TinyTapeout/ttsky25a-tinyQVb/fpga/generic/top.v

/*
 * Copyright (c) 2024-2025 Michael Bell
 * SPDX-License-Identifier: Apache-2.0
 */

`default_nettype none

module tinyQV_top (
        input clk,
        input rst_n,

        input [7:0] ui_in,
        output [7:0] uo_out

);
    localparam CLOCK_MHZ = 14;

    // Address to peripheral map
    localparam PERI_NONE = 4'h0;
    localparam PERI_GPIO_OUT_SEL = 4'h3;
    localparam PERI_DEBUG_UART = 4'h6;
    localparam PERI_DEBUG_UART_STATUS = 4'h7;
    localparam PERI_DEBUG = 4'hC;
    localparam PERI_USER = 4'hF;

    // Register the reset on the negative edge of clock for safety.
    // This also allows the option of async reset in the design, which might be preferable in some cases
    /* verilator lint_off SYNCASYNCNET */
    reg rst_reg_n;
    /* verilator lint_on SYNCASYNCNET */
    always @(negedge clk) rst_reg_n <= rst_n;

    // Bidirs are used for SPI interface
    wire [3:0] qspi_data_in;
    wire [3:0] qspi_data_out;
    wire [3:0] qspi_data_oe;
    wire       qspi_clk_out;
    wire       qspi_flash_select;
    wire       qspi_ram_a_select;
    wire       qspi_ram_b_select;

    sim_qspi_pmod i_qspi (
        .qspi_data_in(qspi_data_out & qspi_data_oe),
        .qspi_data_out(qspi_data_in),
        .qspi_clk(qspi_clk_out),

        .qspi_flash_select(qspi_flash_select),
        .qspi_ram_a_select(qspi_ram_a_select),
        .qspi_ram_b_select(qspi_ram_b_select)
    );

    wire [27:0] addr;
    wire  [1:0] write_n;
    wire  [1:0] read_n;
    wire        read_complete;
    wire [31:0] data_to_write;

    wire        data_ready;
    reg [31:0] data_from_read;

    wire       debug_instr_complete;
    wire       debug_instr_ready;
    wire       debug_instr_valid;
    wire       debug_fetch_restart;
    wire       debug_data_ready;
    wire       debug_interrupt_pending;
    wire       debug_branch;
    wire       debug_early_branch;
    wire       debug_ret;
    wire       debug_reg_wen;
    wire       debug_counter_0;
    wire       debug_data_continue;
    wire       debug_stall_txn;
    wire       debug_stop_txn;
    wire [3:0] debug_rd;

    wire       debug_uart_txd;
    wire       debug_signal;
    reg  [7:6] gpio_out_sel;

    reg [3:0] connect_peripheral;

    // Debug
    reg debug_register_data;
    reg [3:0] debug_rd_r;

    // Debug UART - runs fast to reduce the width of the count necessary for the divider!
    wire debug_uart_tx_busy;
    wire debug_uart_tx_start = write_n != 2'b11 && connect_peripheral == PERI_DEBUG_UART;

    // Time
    wire time_pulse;

    // Peripherals interface
    wire [7:0] peri_out;
    wire [31:0] peri_data_out;
    wire        peri_data_ready;
    wire [15:2] peri_interrupts;

    // Peripherals get synchronized ui_in.
    reg [7:0] ui_in_sync0;
    reg [7:0] ui_in_sync;
    always @(posedge clk) begin
        ui_in_sync0 <= ui_in;
        ui_in_sync <= ui_in_sync0;
    end

    // Interrupt requests
    wire [15:0] interrupt_req = {peri_interrupts, ui_in_sync[1:0]};

    tinyQV i_tinyqv(
        .clk(clk),
        .rstn(rst_reg_n),

        .data_addr(addr),
        .data_write_n(write_n),
        .data_read_n(read_n),
        .data_read_complete(read_complete),
        .data_out(data_to_write),

        .data_ready(data_ready),
        .data_in(data_from_read),

        .interrupt_req(interrupt_req),
        .time_pulse(time_pulse),

        .spi_data_in(rst_reg_n ? qspi_data_in : 4'b0010),
        .spi_data_out(qspi_data_out),
        .spi_data_oe(qspi_data_oe),
        .spi_clk_out(qspi_clk_out),
        .spi_flash_select(qspi_flash_select),
        .spi_ram_a_select(qspi_ram_a_select),
        .spi_ram_b_select(qspi_ram_b_select),

        .debug_instr_complete(debug_instr_complete),
        .debug_instr_ready(debug_instr_ready),
        .debug_instr_valid(debug_instr_valid),
        .debug_fetch_restart(debug_fetch_restart),
        .debug_data_ready(debug_data_ready),
        .debug_interrupt_pending(debug_interrupt_pending),
        .debug_branch(debug_branch),
        .debug_early_branch(debug_early_branch),
        .debug_ret(debug_ret),
        .debug_reg_wen(debug_reg_wen),
        .debug_counter_0(debug_counter_0),
        .debug_data_continue(debug_data_continue),
        .debug_stall_txn(debug_stall_txn),
        .debug_stop_txn(debug_stop_txn),
        .debug_rd(debug_rd)
    );

    assign uo_out[0] = peri_out[0];
    assign uo_out[1] = peri_out[1];
    assign uo_out[2] = debug_register_data ? debug_rd_r[0] : peri_out[2];
    assign uo_out[3] = debug_register_data ? debug_rd_r[1] : peri_out[3];
    assign uo_out[4] = debug_register_data ? debug_rd_r[2] : peri_out[4];
    assign uo_out[5] = debug_register_data ? debug_rd_r[3] : peri_out[5];
    assign uo_out[6] = gpio_out_sel[6] ? peri_out[6] : debug_uart_txd;
    assign uo_out[7] = gpio_out_sel[7] ? peri_out[7] : debug_signal;

    tinyQV_peripherals #(.CLOCK_MHZ(CLOCK_MHZ)) i_peripherals (
        .clk(clk),
        .rst_n(rst_reg_n),

        .ui_in(ui_in_sync),
        .uo_out(peri_out),

        .addr_in(addr[10:0]),
        .data_in(data_to_write),

        .data_write_n(write_n),
        .data_read_n(read_n),

        .data_out(peri_data_out),
        .data_ready(peri_data_ready),

        .data_read_complete(read_complete),

        .user_interrupts(peri_interrupts)
    );

    always @(*) begin
        if ({addr[27:6], addr[1:0]} == 24'h800000) 
            connect_peripheral = addr[5:2];
        else if (addr[27:11] == 17'h10000)
            connect_peripheral = PERI_USER;
        else
            connect_peripheral = PERI_NONE;
    end

    // Read data
    always @(*) begin
        case (connect_peripheral)
            PERI_GPIO_OUT_SEL:data_from_read = {24'h0, gpio_out_sel, 6'h0};
            PERI_DEBUG_UART_STATUS: data_from_read = {31'h0, debug_uart_tx_busy};
            PERI_USER:        data_from_read = peri_data_out;
            default:          data_from_read = 32'hFFFF_FFFF;
        endcase
    end

    assign data_ready = (connect_peripheral == PERI_USER) ? peri_data_ready : 1'b1;

    // GPIO Out
    always @(posedge clk) begin
        if (!rst_reg_n) begin
            gpio_out_sel <= {!ui_in[0], 1'b0};
        end
        if (write_n != 2'b11) begin
            if (connect_peripheral == PERI_GPIO_OUT_SEL) gpio_out_sel <= data_to_write[7:6];
        end
    end

    uart_tx #(.CLK_HZ(CLOCK_MHZ*1_000_000), .BIT_RATE(1_000_000)) i_debug_uart_tx(
        .clk(clk),
        .resetn(rst_reg_n),
        .uart_txd(debug_uart_txd),
        .uart_tx_en(debug_uart_tx_start),
        .uart_tx_data(data_to_write[7:0]),
        .uart_tx_busy(debug_uart_tx_busy) 
    );

    reg [7:0] time_count;
    always @(posedge clk) begin
        if (!rst_reg_n) begin
            time_count <= 0;
        end else begin
            if (time_count == (CLOCK_MHZ - 1)) time_count <= 0;
            else time_count <= time_count + 1;
        end
    end
    assign time_pulse = time_count == (CLOCK_MHZ - 1);

    // Debug
    always @(posedge clk) begin
        if (!rst_reg_n)
            debug_register_data <= ui_in[1];
        else if (write_n != 2'b11 && connect_peripheral == PERI_DEBUG)
            debug_register_data <= data_to_write[0];
    end

    always @(posedge clk) begin
        debug_rd_r <= debug_rd;
    end

/*
    reg [15:0] debug_signals;
    always @(*) begin
        debug_signals  = {debug_instr_complete,
                          debug_instr_ready,
                          debug_instr_valid,
                          debug_fetch_restart,
                          read_n != 2'b11,
                          write_n != 2'b11,
                          debug_data_ready,
                          debug_interrupt_pending,
                          debug_branch,
                          debug_early_branch,
                          debug_ret,
                          debug_reg_wen,
                          debug_counter_0,
                          debug_data_continue,
                          debug_stall_txn,
                          debug_stop_txn};
    end
    assign debug_signal = debug_signals[ui_in[6:3]];
*/
    assign debug_signal = 1'b0;

endmodule
