TinyTapeout/ttsky25a-tinyQVb/src/user_peripherals/AY8913/noise.v

// FROM General Instruments AY-3-8910 / 8912 Programmable Sound Generator (PSG) data Manual.
// Section 3.2 Noise Generator Control
// ...
// Note that the 6-bit value in R11 is a period value-the higher the value in the register,
// the lower the resultant noise frequency. Note also that, as with the Tone Period,
// the lowest period value is 00001 (divide by 1); the highest period value is 11111 (divide by 3110).

// LFSR in hardware implementation uses 2 taps and adds extra 1 when LFSR is equal to 0.

// MAME does not check for LFSR==0 and uses single XOR with 2 taps.
// Instead MAME initialises LFSR with 1 upon reset. This is not a bug!
// The following Python code validates that if LFSR is initialised with 1
//  - LFSR will never reach 0 and
//  - the cycle is 131070 iterations before LFSR reaches 1 again
//
//  lfsr = 1
//  for x in range(65536*16): lfsr = lfsr >> 1 | (((lfsr&1) ^ ((lfsr>>3)&1))<<16); print (lfsr,x) if lfsr <= 1 else None
//
// The following Python code measures randomness of LFSR
//  - 0/1 are distributed equally
//  - flips occur 50% of time - the same as when using rand()%1. NOTE that this effectively halves the frequency.
//
//  flips = 0; ones = 0; lfsr = 1
//  for x in range(65536*16): last = lfsr&1; lfsr = lfsr >> 1 | (((lfsr&1) ^ ((lfsr>>3)&1))<<16); flips += (last != lfsr&1); ones += lfsr&1==1
//  print(flips/(65536*16), ones/(65536*16))

module noise #( parameter LFSR_BITS = 17, LFSR_TAP0 = 0, LFSR_TAP1 = 3, parameter PERIOD_BITS = 5 ) (
    input  wire clk,
    input  wire enable,
    input  wire reset,
    input  wire [PERIOD_BITS-1:0] period,

    output wire  out
);
    wire trigger;
    tone #(.PERIOD_BITS(PERIOD_BITS)) tone (
        .clk(clk),
        .enable(enable),
        .reset(reset),
        .period(period),
        .out(trigger));

    wire trigger_edge;
    signal_edge signal_edge(
        .clk(clk),
        .reset(reset),
        .signal(trigger),
        .on_posedge(trigger_edge)               // similar to noise_shift_clk_cond [see: lvd]
                                                // @TODO: look-ahead rising-edge detect the noise flip-flop [see: dnotq]
    );

    reg [LFSR_BITS-1:0] lfsr;
    wire is_lfsr_zero = (lfsr == 0);            // more readable, but equivalent to
                                                // hardware implementation ~(|lfsr) [see: lvd]
    wire lfsr_shift_in = (lfsr[LFSR_TAP0] ^ lfsr[LFSR_TAP1]) | is_lfsr_zero;

    always @(posedge clk) begin
        if (trigger_edge)
            lfsr <= {lfsr_shift_in, lfsr[LFSR_BITS-1:1]};
    end
    assign out = ~lfsr[0];
endmodule
