TinyTapeout/ttsky25a-tinyQVb/src/user_peripherals/vgascope/vga_timing.v

`default_nettype none

// courtesy of htfab, https://github.com/htfab/tinyqv-baby-vga
// (modified to save gates and remove interrupt code)

module vga_timing_cc (
    input wire clk,
    input wire rst_n,
    output reg [5:0] x_hi,
    output reg [4:0] x_lo,
    output reg [4:0] y_hi,
    output reg [5:0] y_lo,
    output reg hsync,
    output reg vsync,
    output wire blank
);

// 1024x768 60Hz CVT (63.5 MHz pixel clock, rounded to 64 MHz) - courtesy of RebelMike

`define H_ROLL   31
`define H_FPORCH (32 * 32)
`define H_SYNC   (33 * 32 + 16)
`define H_BPORCH (36 * 32 + 24)
`define H_NEXT   (41 * 32 + 15)

`define V_ROLL   47
`define V_FPORCH (16 * 64)
`define V_SYNC   (16 * 64 + 3)
`define V_BPORCH (16 * 64 + 7)
`define V_NEXT   (16 * 64 + 35)

always @(posedge clk) begin
    if (!rst_n) begin
        x_hi <= 0;
        x_lo <= 0;
        y_hi <= 0;
        y_lo <= 0;
        hsync <= 0;
        vsync <= 0;
    end else begin
        if ({x_hi, x_lo} == `H_NEXT) begin
            x_hi <= 0;
            x_lo <= 0;
        end else if (x_lo == `H_ROLL) begin
            x_hi <= x_hi + 1;
            x_lo <= 0;
        end else begin
            x_lo <= x_lo + 1;
        end
        if ({x_hi, x_lo} == `H_SYNC) begin
            if({y_hi, y_lo} == `V_NEXT) begin
                y_hi <= 0;
                y_lo <= 0;
            end else if (y_lo == `V_ROLL) begin
                y_hi <= y_hi + 1;
                y_lo <= 0;
            end else begin
                y_lo <= y_lo + 1;
            end
        end
        hsync <= !({x_hi, x_lo} >= `H_SYNC && {x_hi, x_lo} < `H_BPORCH);
        vsync <= ({y_hi, y_lo} >= `V_SYNC && {y_hi, y_lo} < `V_BPORCH);
    end
end

//assign blank = ({x_hi, x_lo} >= `H_FPORCH || {y_hi, y_lo} >= `V_FPORCH);
assign blank = x_hi[5] | y_hi[4];

endmodule
