TinyTapeout/ttsky25a-tinyQVb/test/test.py

# SPDX-FileCopyrightText: © 2024 Michael Bell
# SPDX-License-Identifier: MIT

import random

import cocotb
from cocotb.clock import Clock
from cocotb.triggers import ClockCycles, Timer, FallingEdge, RisingEdge
from cocotb.utils import get_sim_time

from riscvmodel.insn import *

from riscvmodel.regnames import x0, x1, sp, gp, tp, a0, a1, a2, a3, a4
from riscvmodel import csrnames
from riscvmodel.variant import RV32E

from test_util import reset, start_read, send_instr, start_nops, stop_nops, read_byte, read_reg, load_reg, expect_load, expect_store

@cocotb.test()
async def test_start(dut):
  dut._log.info("Start")
  
  clock = Clock(dut.clk, 15.624, units="ns")
  cocotb.start_soon(clock.start())

  # Reset
  await reset(dut)
  
  # Should start reading flash after 1 cycle
  await ClockCycles(dut.clk, 1)
  await start_read(dut, 0)
  
  # Read ID
  await send_instr(dut, InstructionLW(x1, tp, 0x8).encode())
  assert await read_reg(dut, x1) == ord('B')
  
  for i in range(8):
    await send_instr(dut, InstructionADDI(i+8, x0, 0x102*i).encode())

  # Test UART TX
  uart_byte = 0x54
  await send_instr(dut, InstructionADDI(x1, x0, uart_byte).encode())
  await send_instr(dut, InstructionSW(tp, x1, 0x80).encode())

  await start_nops(dut)
  bit_time = 8680
  await Timer(bit_time / 2, "ns")
  assert dut.uart_tx.value == 0
  for i in range(8):
      await Timer(bit_time, "ns")
      assert dut.uart_tx.value == (uart_byte & 1)
      uart_byte >>= 1
  await Timer(bit_time, "ns")
  assert dut.uart_tx.value == 1

  # Test UART RX
  for j in range(5):
    assert dut.uart_rts.value == 0

    uart_rx_byte = random.randint(0, 255)
    val = uart_rx_byte
    dut.uart_rx.value = 0
    await Timer(bit_time, "ns")
    for i in range(8):
        dut.uart_rx.value = val & 1
        await Timer(bit_time, "ns")
        assert dut.uart_rts.value == 0
        val >>= 1
    dut.uart_rx.value = 1
    await Timer(bit_time, "ns")
    assert dut.uart_rts.value == 0

    uart_rx_byte2 = random.randint(0, 255)
    val = uart_rx_byte2
    dut.uart_rx.value = 0
    await Timer(bit_time, "ns")
    for i in range(8):
        dut.uart_rx.value = val & 1
        await Timer(bit_time, "ns")
        assert dut.uart_rts.value == 1
        val >>= 1
    dut.uart_rx.value = 1
    await Timer(bit_time, "ns")
    assert dut.uart_rts.value == 1

    await stop_nops()

    await send_instr(dut, InstructionLW(x1, tp, 0x84).encode())
    await read_byte(dut, x1, 0x2)
    await send_instr(dut, InstructionLW(x1, tp, 0x80).encode())
    await read_byte(dut, x1, uart_rx_byte)
    assert dut.uart_rts.value == 0
    await send_instr(dut, InstructionLW(x1, tp, 0x84).encode())
    await read_byte(dut, x1, 0x2)
    await send_instr(dut, InstructionLW(x1, tp, 0x80).encode())
    await read_byte(dut, x1, uart_rx_byte2)
    assert dut.uart_rts.value == 0
    await send_instr(dut, InstructionLW(x1, tp, 0x84).encode())
    await read_byte(dut, x1, 0)

    if j != 4:
        await start_nops(dut)

  # Test Debug UART TX
  uart_byte = 0x5A
  await send_instr(dut, InstructionADDI(x1, x0, uart_byte).encode())
  await read_byte(dut, x1, uart_byte)

  # GPIO
  await send_instr(dut, InstructionADDI(x1, x0, 0xff).encode())
  await send_instr(dut, InstructionSW(tp, x1, 0x0c).encode())

  for i in range(40):
    gpio_sel = random.randint(0, 255)
    gpio_out = random.randint(0, 255)
    for j in range(8):
        await send_instr(dut, InstructionADDI(x1, x0, (gpio_sel >> j) & 1).encode())
        await send_instr(dut, InstructionSW(tp, x1, 0x60 + j*4).encode())
    await send_instr(dut, InstructionADDI(x1, x0, gpio_out).encode())
    await send_instr(dut, InstructionSW(tp, x1, 0x40).encode())
    for _ in range(3):
        await send_instr(dut, InstructionADDI(x0, x0, 0).encode())
    assert (dut.uo_out.value & gpio_sel) == (gpio_out & gpio_sel)

  # Ensure uo_out is normally high
  await send_instr(dut, InstructionADDI(x1, x0, 0x80).encode())
  await send_instr(dut, InstructionSW(tp, x1, 0x40).encode())

@cocotb.test()
async def test_timer(dut):
    dut._log.info("Start")

    clock = Clock(dut.clk, 15.624, units="ns")
    cocotb.start_soon(clock.start())

    mhz_clock = Clock(dut.mhz_clk, 1000, units="ns")
    cocotb.start_soon(mhz_clock.start())

    await FallingEdge(dut.mhz_clk)

    # Reset
    await reset(dut)
    start_time = get_sim_time("ns")

    # Should start reading flash after 1 cycle
    await ClockCycles(dut.clk, 1)
    await start_read(dut, 0)

    # Read time
    await send_instr(dut, InstructionLW(x1, x0, -0x100).encode())
    assert await read_reg(dut, x1) <= 1

    await start_nops(dut)
    await Timer(5, "us")
    await stop_nops()

    # Read time
    await send_instr(dut, InstructionLW(x1, x0, -0x100).encode())
    assert 6 <= await read_reg(dut, x1) <= 8

    # Set timecmp
    await send_instr(dut, InstructionADDI(x1, x0, 20).encode())
    await send_instr(dut, InstructionSW(x0, x1, -0xfc).encode())

    # And read back
    await send_instr(dut, InstructionLW(a0, x0, -0xfc).encode())
    assert await read_reg(dut, a0) == 20

    # Enable timer interrupt
    await send_instr(dut, InstructionADDI(x1, x0, 0x80).encode())
    await send_instr(dut, InstructionCSRRW(x0, x1, csrnames.mie).encode())

    while dut.qspi_flash_select.value == 0:
        cur_time = get_sim_time("ns") - start_time
        await send_instr(dut, InstructionADDI(x0, x0, 0).encode(), cur_time > 19300)
        assert cur_time <= 20500

    await ClockCycles(dut.clk, 2)
    await start_read(dut, 8)
    await send_instr(dut, InstructionCSRRS(a0, x0, csrnames.mcause).encode())
    assert await read_reg(dut, a0) == 0x80000007

@cocotb.test()
async def test_time_limit(dut):
    dut._log.info("Start")

    clock = Clock(dut.clk, 15.624, units="ns")
    cocotb.start_soon(clock.start())

    # Reset
    await reset(dut)

    # Should start reading flash after 1 cycle
    await ClockCycles(dut.clk, 1)
    await start_read(dut, 0)

    # Read time limit
    await send_instr(dut, InstructionLW(x1, tp, 0x2c).encode())
    assert await read_reg(dut, x1) == 0x3f

    # Halve the divider, time should now advance twice as fast
    await send_instr(dut, InstructionADDI(x1, x0, 0x1f).encode())
    await send_instr(dut, InstructionSW(tp, x1, 0x2c).encode())

    # Read time
    await send_instr(dut, InstructionLW(x1, x0, -0x100).encode())
    start_time = await read_reg(dut, x1)

    await start_nops(dut)
    await Timer(5, "us")
    await stop_nops()

    # Read time
    await send_instr(dut, InstructionLW(x1, x0, -0x100).encode())
    assert start_time+10 <= await read_reg(dut, x1) <= start_time+12

    # Set divider to 96, time should advance more slowly
    await send_instr(dut, InstructionADDI(x1, x0, 0x5f).encode())
    await send_instr(dut, InstructionSW(tp, x1, 0x2c).encode())

    # Read time
    await send_instr(dut, InstructionLW(x1, x0, -0x100).encode())
    start_time = await read_reg(dut, x1)

    await start_nops(dut)
    await Timer(9, "us")
    await stop_nops()

    # Read time
    await send_instr(dut, InstructionLW(x1, x0, -0x100).encode())
    assert start_time+6 <= await read_reg(dut, x1) <= start_time+8

@cocotb.test()
async def test_csr(dut):
    dut._log.info("Start")
    
    clock = Clock(dut.clk, 15.624, units="ns")
    cocotb.start_soon(clock.start())

    # Reset
    await reset(dut, 1, 0x3)
    
    # Should start reading flash after 1 cycle
    await ClockCycles(dut.clk, 1)
    await start_read(dut, 0)

    # Disable interrupts and read current value of register
    await send_instr(dut, InstructionADDI(a3, x0, 8).encode())
    await send_instr(dut, InstructionCSRRC(a3, a3, csrnames.mstatus).encode())
    assert await read_reg(dut, a3) == 0xC

    # Reenable interrupts
    await send_instr(dut, InstructionCSRRS(a3, a3, csrnames.mstatus).encode())
    assert await read_reg(dut, a3) == 0x4

@cocotb.test()
async def test_debug_reg(dut):
  dut._log.info("Start")
  
  clock = Clock(dut.clk, 15.624, units="ns")
  cocotb.start_soon(clock.start())

  # Reset
  await reset(dut, 1, 0x3)
  
  # Should start reading flash after 1 cycle
  await ClockCycles(dut.clk, 1)
  await start_read(dut, 0)
  dut.ui_in_base.value = 0b01101000 # Register write enable
  
  val = 0
  for i in range(8):
    val += 0x102 * i
    await send_instr(dut, InstructionADDI(i+8, x0 if i == 0 else (i+7), 0x102*i).encode())
    await start_nops(dut)
    for i in range(24):
        if dut.uo_out[7].value == 1:
            break
        await ClockCycles(dut.clk, 1)
    else:
        assert False

    await ClockCycles(dut.clk, 1)
    for j in range(8):
        assert ((dut.uo_out.value >> 2) & 0xF) == ((val >> (4 * j)) & 0xF)
        await ClockCycles(dut.clk, 1)
    await stop_nops()

async def test_pwm(dut, pwm_value, pwm_strobe):
    
    dut._log.info(f"sync to PWM rising edge")
    # sync to pwm gen
    await RisingEdge(dut.qspi_ram_b_select)
    await FallingEdge(dut.qspi_ram_b_select)
    await RisingEdge(dut.qspi_ram_b_select)
    await ClockCycles(dut.clk, 1)
    dut._log.info(f"assert {pwm_strobe * pwm_value} clocks of PWM high")
    # assert the PWM is on for the length of time
    for i in range(pwm_value):
        assert dut.uio_out[7].value == 1, f"failed on cycle {i}"
        await ClockCycles(dut.clk, pwm_strobe)
    dut._log.info(f"assert {pwm_strobe * (255 - pwm_value)} clocks of PWM low")
    for i in range(255 - pwm_value):
        assert dut.uio_out[7].value == 0, f"failed on cycle {i}"
        await ClockCycles(dut.clk, pwm_strobe)

@cocotb.test()
async def test_audio(dut):
    dut._log.info("Start")

    clock = Clock(dut.clk, 15.624, units="ns")
    cocotb.start_soon(clock.start())

    # Reset
    await reset(dut)
    
    # Should start reading flash after 1 cycle
    await ClockCycles(dut.clk, 1)
    await start_read(dut, 0)

    # Enable PWM audio
    await send_instr(dut, InstructionADDI(x1, x0, 0x7).encode())
    await send_instr(dut, InstructionSW(tp, x1, 0x50).encode())
    
    for pwm in (5, 23, 57, 240):
        await send_instr(dut, InstructionADDI(x1, x0, pwm).encode())
        await send_instr(dut, InstructionSB(tp, x1, 0x450).encode())
        await start_nops(dut)

        await test_pwm(dut, pwm, 1)

        await stop_nops()


@cocotb.test()
async def test_load_bug(dut):
  dut._log.info("Start")
  
  clock = Clock(dut.clk, 15.624, units="ns")
  cocotb.start_soon(clock.start())

  # Reset
  await reset(dut)

  input_byte = 0b01101000
  dut.ui_in.value = input_byte

  def encode_clwsp(reg, base_reg, imm):
    scrambled = (((imm << (12 - 5)) & 0b1000000000000) |
                    ((imm << ( 4 - 2)) & 0b0000001110000) |
                    ((imm >> ( 6 - 2)) & 0b0000000001100))
    if base_reg == 2:
        return 0x4002 | scrambled | (reg << 7)
    else:
        return 0x6002 | scrambled | (reg << 7)  
  
  # Should start reading flash after 1 cycle
  await ClockCycles(dut.clk, 1)
  await start_read(dut, 0)
  await send_instr(dut, InstructionAUIPC(sp, 0x1001).encode())
  await send_instr(dut, InstructionADDI(a0, x0, 0x001).encode())
  await send_instr(dut, InstructionBEQ(a0, x0, 270).encode())

  await send_instr(dut, encode_clwsp(a3, tp, 0x44))
  await send_instr(dut, encode_clwsp(a2, sp, 12))
  await expect_load(dut, 0x1001000 + 12, 0x123)
  await read_byte(dut, a3, input_byte)
  await read_byte(dut, a2, 0x123)

@cocotb.test()
async def test_load_throughput(dut):
    dut._log.info("Start")

    clock = Clock(dut.clk, 15.624, units="ns")
    cocotb.start_soon(clock.start())

    # Reset
    await reset(dut)

    input_byte = 0b01101000
    dut.ui_in.value = input_byte

    def encode_clwsp(reg, base_reg, imm):
        scrambled = (((imm << (12 - 5)) & 0b1000000000000) |
                        ((imm << ( 4 - 2)) & 0b0000001110000) |
                        ((imm >> ( 6 - 2)) & 0b0000000001100))
        if base_reg == 2:
            return 0x4002 | scrambled | (reg << 7)
        else:
            return 0x6002 | scrambled | (reg << 7)  
  
    def encode_cswsp(base_reg, reg, imm):
        scrambled = (((imm << ( 9 - 2)) & 0b1111000000000) |
                        ((imm << ( 7 - 6)) & 0b0000110000000))
        if base_reg == 2:
            return 0xC002 | scrambled | (reg << 2)
        else:
            return 0xE002 | scrambled | (reg << 2)

    # Should start reading flash after 1 cycle
    await ClockCycles(dut.clk, 1)
    await start_read(dut, 0)
    await send_instr(dut, InstructionAUIPC(sp, 0x1001).encode())
    await send_instr(dut, InstructionADDI(a0, x0, 0x001).encode())
    await send_instr(dut, InstructionBEQ(a0, x0, 270).encode())

    for i in range(32):
        await send_instr(dut, encode_clwsp(a2, sp, i*4))
        await send_instr(dut, encode_cswsp(tp, a2, 0x3c0))
        await expect_load(dut, 0x1001000 + i*4, i)

@cocotb.test()
async def test_multistore_interrupt(dut):
    dut._log.info("Start")

    clock = Clock(dut.clk, 15.624, units="ns")
    cocotb.start_soon(clock.start())

    # Reset
    await reset(dut)

    input_byte = 0b01101000
    dut.ui_in.value = input_byte

    def encode_sw4(base_reg, reg, imm):
        instr = InstructionSW(base_reg, reg, imm).encode()
        return instr | (7 << 12)

    # Should start reading flash after 1 cycle
    await ClockCycles(dut.clk, 1)
    await start_read(dut, 0)

    # Transmit a byte and enable interrupt on writeable
    await send_instr(dut, InstructionSW(tp, x0, 0x80).encode())
    await send_instr(dut, InstructionLUI(a0, 0x80).encode())
    await send_instr(dut, InstructionCSRRW(x0, a0, csrnames.mie).encode())

    await send_instr(dut, InstructionADDI(a1, x0, 0x10).encode())
    await send_instr(dut, InstructionADDI(a2, x0, 0x11).encode())
    await send_instr(dut, InstructionADDI(a3, x0, 0x12).encode())
    await send_instr(dut, InstructionADDI(a4, x0, 0x13).encode())

    for i in range(100):
        await send_instr(dut, encode_sw4(gp, a1, i*16))
        await expect_store(dut, 0x1000400 + i*16, 16)

    # Interrupt should be pending
    await send_instr(dut, InstructionCSRRS(a0, x0, csrnames.mip).encode())
    assert (await read_reg(dut, a0, False) & 0x80000) == 0x80000

### Random operation testing ###
reg = [0] * 16

# Each Op does reg[d] = fn(a, b)
# fn will access reg global array
class SimpleOp:
    def __init__(self, rvm_insn, fn, name):
        self.rvm_insn = rvm_insn
        self.fn = fn
        self.name = name
        self.is_mem_op = False

    def randomize(self):
        self.rvm_insn_inst = self.rvm_insn()
        self.rvm_insn_inst.randomize(variant=RV32E)
    
    def execute_fn(self, rd, rs1, arg2):
        if rd != 0 and rd != 3 and rd != 4:
            reg[rd] = self.fn(rs1, arg2)
            while reg[rd] < -0x80000000: reg[rd] += 0x100000000
            while reg[rd] > 0x7FFFFFFF:  reg[rd] -= 0x100000000

    def encode(self, rd, rs1, arg2):
        return self.rvm_insn(rd, rs1, arg2).encode()
    
    def get_valid_rd(self):
        return random.randint(0, 15)

    def get_valid_rs1(self):
        return random.randint(0, 15)

    def get_valid_arg2(self):
        return (random.randint(0, 15) if issubclass(self.rvm_insn, InstructionRType) else 
                self.rvm_insn_inst.shamt.value if issubclass(self.rvm_insn, InstructionISType) else
                self.rvm_insn_inst.imm.value)

def encode_ci(reg, imm, opcode):
    scrambled = (((imm << (12 - 5)) & 0b1000000000000) |
                    ((imm << ( 2 - 0)) & 0b0000001111100))
    return opcode | scrambled | (reg << 7)

def encode_cli(reg, imm):
    return encode_ci(reg, imm, 0x4001)

def encode_caddi(reg, imm):
    return encode_ci(reg, imm, 0x0001)

def encode_cslli(reg, imm):
    return encode_ci(reg, imm, 0x0002)

def encode_ci2(reg, imm, opcode):
    return encode_ci(reg - 8, imm, opcode)

def encode_csrli(reg, imm):
    return encode_ci2(reg, imm, 0x8001)

def encode_csrai(reg, imm):
    return encode_ci2(reg, imm, 0x8401)

def encode_candi(reg, imm):
    return encode_ci2(reg, imm, 0x8801)

def encode_cnot(reg, _):
    return 0x9c75 | ((reg - 8) << 7)

def encode_czext_b(reg, _):
    return 0x9c61 | ((reg - 8) << 7)

def encode_czext_h(reg, _):
    return 0x9c69 | ((reg - 8) << 7)

def encode_cr(dest_reg, src_reg, opcode):
    return opcode | (dest_reg << 7) | (src_reg << 2)

def encode_cmv(dest_reg, src_reg):
    return encode_cr(dest_reg, src_reg, 0x8002)

def encode_cadd(dest_reg, src_reg):
    return encode_cr(dest_reg, src_reg, 0x9002)

def encode_cmul16(dest_reg, src_reg):
    return encode_cr(dest_reg, src_reg, 0xA002)

def encode_ca(dest_reg, src_reg, opcode):
    return opcode | ((dest_reg - 8) << 7) | ((src_reg - 8) << 2)

def encode_csub(dest_reg, src_reg):
    return encode_ca(dest_reg, src_reg, 0x8C01)

def encode_cxor(dest_reg, src_reg):
    return encode_ca(dest_reg, src_reg, 0x8C21)

def encode_cor(dest_reg, src_reg):
    return encode_ca(dest_reg, src_reg, 0x8C41)

def encode_cand(dest_reg, src_reg):
    return encode_ca(dest_reg, src_reg, 0x8C61)

class CIOp:
    def __init__(self, encoder, min_rs1, min_imm, fn, name):
        self.encoder = encoder
        self.fn = fn
        self.name = name
        self.min_rs1 = min_rs1
        self.min_imm = min_imm
        self.is_mem_op = False

    def randomize(self):
        self.rs1 = random.randint(self.min_rs1, 15)
        self.imm = random.randint(self.min_imm, 31)
    
    def execute_fn(self, rd, rs1, arg2):
        if rd != 0 and rd != 3 and rd != 4:
            reg[rd] = self.fn(rs1, arg2)
            while reg[rd] < -0x80000000: reg[rd] += 0x100000000
            while reg[rd] > 0x7FFFFFFF:  reg[rd] -= 0x100000000

    def encode(self, rd, rs1, arg2):
        return self.encoder(rs1, arg2)
    
    def get_valid_rd(self):
        return self.rs1

    def get_valid_rs1(self):
        return self.rs1

    def get_valid_arg2(self):
        return self.imm

class CROp:
    def __init__(self, encoder, min_reg, fn, name):
        self.encoder = encoder
        self.fn = fn
        self.name = name
        self.min_reg = min_reg
        self.is_mem_op = False

    def randomize(self):
        self.rs1 = random.randint(self.min_reg, 15)
        self.rs2 = random.randint(self.min_reg, 15)
    
    def execute_fn(self, rd, rs1, arg2):
        if rd != 0 and rd != 3 and rd != 4:
            reg[rd] = self.fn(rs1, arg2)
            while reg[rd] < -0x80000000: reg[rd] += 0x100000000
            while reg[rd] > 0x7FFFFFFF:  reg[rd] -= 0x100000000

    def encode(self, rd, rs1, arg2):
        return self.encoder(rs1, arg2)
    
    def get_valid_rd(self):
        return self.rs1

    def get_valid_rs1(self):
        return self.rs1

    def get_valid_arg2(self):
        return self.rs2

class InstructionCZERO_EQZ(InstructionRType):
    def __init__(self, rd = None, rs1 = None, rs2 = None):
        self.rd = rd
        self.rs1 = rs1
        self.rs2 = rs2
        self.op = 5

    def execute(self, model):
        pass

    def encode(self):
        return (0b0000111 << 25) | (self.rs2 << 20) | (self.rs1 << 15) | (self.op << 12) | (self.rd << 7) | 0b0110011

class InstructionCZERO_NEZ(InstructionRType):
    def __init__(self, rd = None, rs1 = None, rs2 = None):
        self.rd = rd
        self.rs1 = rs1
        self.rs2 = rs2
        self.op = 7

    def execute(self, model):
        pass

    def encode(self):
        return (0b0000111 << 25) | (self.rs2 << 20) | (self.rs1 << 15) | (self.op << 12) | (self.rd << 7) | 0b0110011

ops_alu = [
    SimpleOp(InstructionADDI, lambda rs1, imm: reg[rs1] + imm, "+i"),
    SimpleOp(InstructionADD, lambda rs1, rs2: reg[rs1] + reg[rs2], "+"),
    SimpleOp(InstructionSUB, lambda rs1, rs2: reg[rs1] - reg[rs2], "-"),
    SimpleOp(InstructionANDI, lambda rs1, imm: reg[rs1] & imm, "&i"),
    SimpleOp(InstructionAND, lambda rs1, rs2: reg[rs1] & reg[rs2], "&"),
    SimpleOp(InstructionORI, lambda rs1, imm: reg[rs1] | imm, "|i"),
    SimpleOp(InstructionOR, lambda rs1, rs2: reg[rs1] | reg[rs2], "|"),
    SimpleOp(InstructionXORI, lambda rs1, imm: reg[rs1] ^ imm, "^i"),
    SimpleOp(InstructionXOR, lambda rs1, rs2: reg[rs1] ^ reg[rs2], "^"),
    SimpleOp(InstructionSLTI, lambda rs1, imm: 1 if reg[rs1] < imm else 0, "<i"),
    SimpleOp(InstructionSLT, lambda rs1, rs2: 1 if reg[rs1] < reg[rs2] else 0, "<"),
    SimpleOp(InstructionSLTIU, lambda rs1, imm: 1 if (reg[rs1] & 0xFFFFFFFF) < (imm & 0xFFFFFFFF) else 0, "<iu"),
    SimpleOp(InstructionSLTU, lambda rs1, rs2: 1 if (reg[rs1] & 0xFFFFFFFF) < (reg[rs2] & 0xFFFFFFFF) else 0, "<u"),
    SimpleOp(InstructionSLLI, lambda rs1, imm: reg[rs1] << imm, "<<i"),
    SimpleOp(InstructionSLL, lambda rs1, rs2: reg[rs1] << (reg[rs2] & 0x1F), "<<"),
    SimpleOp(InstructionSRLI, lambda rs1, imm: (reg[rs1] & 0xFFFFFFFF) >> imm, ">>li"),
    SimpleOp(InstructionSRL, lambda rs1, rs2: (reg[rs1] & 0xFFFFFFFF) >> (reg[rs2] & 0x1F), ">>l"),
    SimpleOp(InstructionSRAI, lambda rs1, imm: reg[rs1] >> imm, ">>i"),
    SimpleOp(InstructionSRA, lambda rs1, rs2: reg[rs1] >> (reg[rs2] & 0x1F), ">>"),
    SimpleOp(InstructionCZERO_EQZ, lambda rs1, rs2: 0 if reg[rs2] == 0 else reg[rs1], "?0"),
    SimpleOp(InstructionCZERO_NEZ, lambda rs1, rs2: 0 if reg[rs2] != 0 else reg[rs1], "?!0"),
    CIOp(encode_cli, 1, -32, lambda rs1, imm: imm, "=i(c)"),
    CIOp(encode_caddi, 1, -32, lambda rs1, imm: reg[rs1] + imm, "+i(c)"),
    CIOp(encode_cslli, 1, 0, lambda rs1, imm: reg[rs1] << imm, "<<i(c)"),
    CIOp(encode_csrli, 8, 0, lambda rs1, imm: (reg[rs1] & 0xFFFFFFFF) >> imm, ">>li(c)"),
    CIOp(encode_csrai, 8, 0, lambda rs1, imm: reg[rs1] >> imm, ">>li(c)"),
    CIOp(encode_candi, 8, -32, lambda rs1, imm: reg[rs1] & imm, "&i(c)"),
    CIOp(encode_cnot, 8, 0, lambda rs1, imm: ~(reg[rs1] & 0xFFFFFFFF), "~(c)"),
    CIOp(encode_czext_b, 8, 0, lambda rs1, imm: reg[rs1] & 0xFF, "zb(c)"),
    CIOp(encode_czext_h, 8, 0, lambda rs1, imm: reg[rs1] & 0xFFFF, "zh(c)"),
    CROp(encode_cmv, 1, lambda rs1, rs2: reg[rs2], "=(c)"),
    CROp(encode_cadd, 1, lambda rs1, rs2: reg[rs1] + reg[rs2], "+(c)"),
    CROp(encode_cmul16, 1, lambda rs1, rs2: reg[rs1] * (reg[rs2] & 0xFFFF), "*(c)"),
    CROp(encode_csub, 8, lambda rs1, rs2: reg[rs1] - reg[rs2], "-(c)"),
    CROp(encode_cxor, 8, lambda rs1, rs2: reg[rs1] ^ reg[rs2], "^(c)"),
    CROp(encode_cor, 8, lambda rs1, rs2: reg[rs1] | reg[rs2], "|(c)"),
    CROp(encode_cand, 8, lambda rs1, rs2: reg[rs1] & reg[rs2], "&(c)"),
]

@cocotb.test()
async def test_random_alu(dut):
    dut._log.info("Start")
  
    clock = Clock(dut.clk, 15.624, units="ns")
    cocotb.start_soon(clock.start())

    # Reset
    await reset(dut)

    # Should start reading flash after 1 cycle
    await ClockCycles(dut.clk, 1)
    await start_read(dut, 0)
    
    seed = random.randint(0, 0xFFFFFFFF)
    #seed = 1508125843
    debug = False
    for test in range(20):
        random.seed(seed + test)
        dut._log.info("Running test with seed {}".format(seed + test))
        for i in range(1, 16):
            if i == 3: reg[i] = 0x1000400
            elif i == 4: reg[i] = 0x8000000
            else:
                reg[i] = random.randint(-0x80000000, 0x7FFFFFFF)
                if debug: print("Set reg {} to {}".format(i, reg[i]))
                await load_reg(dut, i, reg[i])

        if False:
            for i in range(16):
                reg_value = (await read_reg(dut, i)).signed_integer
                if debug: print("Reg {} is {}".format(i, reg_value))
                assert reg_value == reg[i]

        last_instr = ops_alu[0]
        for i in range(200):
            while True:
                try:
                    instr = random.choice(ops_alu)
                    instr.randomize()
                    rd = instr.get_valid_rd()
                    rs1 = instr.get_valid_rs1()
                    arg2 = instr.get_valid_arg2()

                    instr.execute_fn(rd, rs1, arg2)
                    break
                except ValueError:
                    pass

            if debug: print("x{} = x{} {} {}, now {} {:08x}".format(rd, rs1, arg2, instr.name, reg[rd], instr.encode(rd, rs1, arg2)))
            await send_instr(dut, instr.encode(rd, rs1, arg2))
            #if debug:
            #    assert await read_reg(dut, rd) == reg[rd] & 0xFFFFFFFF

        for i in range(16):
            reg_value = (await read_reg(dut, i))
            if debug: print("Reg x{} = {} should be {}".format(i, reg_value, reg[i]))
            assert reg_value & 0xFFFFFFFF == reg[i] & 0xFFFFFFFF

def encode_clw(reg, base_reg, imm):
    scrambled = (((imm << (10 - 3)) & 0b1110000000000) |
                    ((imm << ( 6 - 2)) & 0b0000001000000) |
                    ((imm >> ( 6 - 5)) & 0b0000000100000))
    return 0x4000 | scrambled | ((base_reg - 8) << 7) | ((reg - 8) << 2)        

def encode_lh(reg, base_reg, imm):
    scrambled = ((imm << (5 - 1)) & 0b100000)
    return 0x8440 | scrambled | ((base_reg - 8) << 7) | ((reg - 8) << 2)

def encode_lhu(reg, base_reg, imm):
    scrambled = ((imm << (5 - 1)) & 0b100000)
    return 0x8400 | scrambled | ((base_reg - 8) << 7) | ((reg - 8) << 2)

def encode_lbu(reg, base_reg, imm):
    scrambled = (((imm << (5 - 1)) & 0b0100000) |
                    ((imm << (6 - 0)) & 0b1000000))
    return 0x8000 | scrambled | ((base_reg - 8) << 7) | ((reg - 8) << 2)

async def set_reg(dut, rd, value):
    await send_instr(dut, InstructionLUI(rd, (value + 0x800) >> 12).encode())
    await send_instr(dut, InstructionADDI(rd, rd, ((value + 0x800) & 0xFFF) - 0x800).encode())
    reg[rd] = value

class CLoadOp:
    def __init__(self, encoder, min_imm, max_imm, imm_mul, bytes, fn, name):
        self.encoder = encoder
        self.fn = fn
        self.name = name
        self.is_mem_op = True
        self.min_imm = min_imm
        self.max_imm = max_imm
        self.imm_mul = imm_mul
        self.bytes = bytes

    def randomize(self):
        self.rd = random.randint(8, 15)
        self.base_reg = random.randint(8, 15)
        self.imm = random.randint(self.min_imm, self.max_imm) * self.imm_mul
        self.val = random.randint(-0x80000000, 0x7fffffff)

    def execute_fn(self, rd, rs1, arg2):
        if rd != 0 and rd != 3 and rd != 4:
            reg[rd] = self.fn(self.val)

    def encode(self, rd, rs1, arg2):
        return self.encoder(rd, rs1, arg2)
    
    def get_valid_rd(self):
        return self.rd

    def get_valid_rs1(self):
        return self.base_reg

    def get_valid_arg2(self):
        return self.imm
    
    async def do_mem_op(self, dut, addr):
        #print("Load {} from addr {:08x}".format(self.val, addr))
        await expect_load(dut, addr, self.val, abs(self.bytes))

class LoadOp:
    def __init__(self, instr, min_imm, max_imm, imm_mul, bytes, fn, name):
        self.instr = instr
        self.fn = fn
        self.name = name
        self.is_mem_op = True
        self.min_imm = min_imm
        self.max_imm = max_imm
        self.imm_mul = imm_mul
        self.bytes = bytes

    def randomize(self):
        self.rd = random.randint(0, 15)
        while True:
            self.base_reg = random.randint(1, 15)
            if self.base_reg not in (gp, tp):
                break
        self.imm = random.randint(self.min_imm, self.max_imm) * self.imm_mul
        self.val = random.randint(-0x80000000, 0x7fffffff)

    def execute_fn(self, rd, rs1, arg2):
        if rd != 0 and rd != 3 and rd != 4:
            reg[rd] = self.fn(self.val)

    def encode(self, rd, rs1, arg2):
        return self.instr(rd, rs1, arg2).encode()
    
    def get_valid_rd(self):
        return self.rd

    def get_valid_rs1(self):
        return self.base_reg

    def get_valid_arg2(self):
        return self.imm
    
    async def do_mem_op(self, dut, addr):
        #print("Load {} from addr {:08x}".format(self.val, addr))
        await expect_load(dut, addr, self.val, abs(self.bytes))

def encode_csw(base_reg, reg, imm):
    scrambled = (((imm << (10 - 3)) & 0b1110000000000) |
                    ((imm << ( 6 - 2)) & 0b0000001000000) |
                    ((imm >> ( 6 - 5)) & 0b0000000100000))
    return 0xC000 | scrambled | ((base_reg - 8) << 7) | ((reg - 8) << 2)

class CStoreOp:
    def __init__(self, encoder, min_imm, max_imm, imm_mul, bytes, fn, name):
        self.encoder = encoder
        self.fn = fn
        self.name = name
        self.is_mem_op = True
        self.min_imm = min_imm
        self.max_imm = max_imm
        self.imm_mul = imm_mul
        self.bytes = bytes

    def randomize(self):
        self.rs1 = random.randint(8, 15)
        while True:
            self.base_reg = random.randint(8, 15)
            if self.base_reg != self.rs1:
                break
        self.imm = random.randint(self.min_imm, self.max_imm) * self.imm_mul

    def execute_fn(self, rd, rs1, arg2):
        pass

    def encode(self, rd, rs1, arg2):
        return self.encoder(self.base_reg, self.rs1, arg2)
    
    def get_valid_rd(self):
        return self.base_reg

    def get_valid_rs1(self):
        return self.rs1

    def get_valid_arg2(self):
        return self.imm
    
    async def do_mem_op(self, dut, addr):
        #print("Load {} from addr {:08x}".format(self.val, addr))
        assert await expect_store(dut, addr, self.bytes) == self.fn(self.rs1)

class StoreOp:
    def __init__(self, instr, min_imm, max_imm, imm_mul, bytes, fn, name):
        self.instr = instr
        self.fn = fn
        self.name = name
        self.is_mem_op = True
        self.min_imm = min_imm
        self.max_imm = max_imm
        self.imm_mul = imm_mul
        self.bytes = bytes

    def randomize(self):
        self.rs1 = random.randint(0, 15)
        while True:
            self.base_reg = random.randint(1, 15)
            if self.base_reg not in (self.rs1, gp, tp):
                break
        self.imm = random.randint(self.min_imm, self.max_imm) * self.imm_mul

    def execute_fn(self, rd, rs1, arg2):
        pass

    def encode(self, rd, rs1, arg2):
        return self.instr(self.base_reg, self.rs1, arg2).encode()
    
    def get_valid_rd(self):
        return self.base_reg

    def get_valid_rs1(self):
        return self.rs1

    def get_valid_arg2(self):
        return self.imm
    
    async def do_mem_op(self, dut, addr):
        #print("Load {} from addr {:08x}".format(self.val, addr))
        assert await expect_store(dut, addr, self.bytes) == self.fn(self.rs1)

ops = [
    SimpleOp(InstructionADDI, lambda rs1, imm: reg[rs1] + imm, "+i"),
    SimpleOp(InstructionADD, lambda rs1, rs2: reg[rs1] + reg[rs2], "+"),
    SimpleOp(InstructionSUB, lambda rs1, rs2: reg[rs1] - reg[rs2], "-"),
    SimpleOp(InstructionANDI, lambda rs1, imm: reg[rs1] & imm, "&i"),
    SimpleOp(InstructionAND, lambda rs1, rs2: reg[rs1] & reg[rs2], "&"),
    SimpleOp(InstructionORI, lambda rs1, imm: reg[rs1] | imm, "|i"),
    SimpleOp(InstructionOR, lambda rs1, rs2: reg[rs1] | reg[rs2], "|"),
    SimpleOp(InstructionXORI, lambda rs1, imm: reg[rs1] ^ imm, "^i"),
    SimpleOp(InstructionXOR, lambda rs1, rs2: reg[rs1] ^ reg[rs2], "^"),
    SimpleOp(InstructionSLTI, lambda rs1, imm: 1 if reg[rs1] < imm else 0, "<i"),
    SimpleOp(InstructionSLT, lambda rs1, rs2: 1 if reg[rs1] < reg[rs2] else 0, "<"),
    SimpleOp(InstructionSLTIU, lambda rs1, imm: 1 if (reg[rs1] & 0xFFFFFFFF) < (imm & 0xFFFFFFFF) else 0, "<iu"),
    SimpleOp(InstructionSLTU, lambda rs1, rs2: 1 if (reg[rs1] & 0xFFFFFFFF) < (reg[rs2] & 0xFFFFFFFF) else 0, "<u"),
    SimpleOp(InstructionSLLI, lambda rs1, imm: reg[rs1] << imm, "<<i"),
    SimpleOp(InstructionSLL, lambda rs1, rs2: reg[rs1] << (reg[rs2] & 0x1F), "<<"),
    SimpleOp(InstructionSRLI, lambda rs1, imm: (reg[rs1] & 0xFFFFFFFF) >> imm, ">>li"),
    SimpleOp(InstructionSRL, lambda rs1, rs2: (reg[rs1] & 0xFFFFFFFF) >> (reg[rs2] & 0x1F), ">>l"),
    SimpleOp(InstructionSRAI, lambda rs1, imm: reg[rs1] >> imm, ">>i"),
    SimpleOp(InstructionSRA, lambda rs1, rs2: reg[rs1] >> (reg[rs2] & 0x1F), ">>"),
    SimpleOp(InstructionCZERO_EQZ, lambda rs1, rs2: 0 if reg[rs2] == 0 else reg[rs1], "?0"),
    SimpleOp(InstructionCZERO_NEZ, lambda rs1, rs2: 0 if reg[rs2] != 0 else reg[rs1], "?!0"),
    CIOp(encode_cli, 1, -32, lambda rs1, imm: imm, "=i(c)"),
    CIOp(encode_caddi, 1, -32, lambda rs1, imm: reg[rs1] + imm, "+i(c)"),
    CIOp(encode_cslli, 1, 0, lambda rs1, imm: reg[rs1] << imm, "<<i(c)"),
    CIOp(encode_csrli, 8, 0, lambda rs1, imm: (reg[rs1] & 0xFFFFFFFF) >> imm, ">>li(c)"),
    CIOp(encode_csrai, 8, 0, lambda rs1, imm: reg[rs1] >> imm, ">>li(c)"),
    CIOp(encode_candi, 8, -32, lambda rs1, imm: reg[rs1] & imm, "&i(c)"),
    CIOp(encode_cnot, 8, 0, lambda rs1, imm: ~(reg[rs1] & 0xFFFFFFFF), "~(c)"),
    CIOp(encode_czext_b, 8, 0, lambda rs1, imm: reg[rs1] & 0xFF, "zb(c)"),
    CIOp(encode_czext_h, 8, 0, lambda rs1, imm: reg[rs1] & 0xFFFF, "zh(c)"),
    CROp(encode_cmv, 1, lambda rs1, rs2: reg[rs2], "=(c)"),
    CROp(encode_cadd, 1, lambda rs1, rs2: reg[rs1] + reg[rs2], "+(c)"),
    CROp(encode_cmul16, 1, lambda rs1, rs2: reg[rs1] * (reg[rs2] & 0xFFFF), "*(c)"),
    CROp(encode_csub, 8, lambda rs1, rs2: reg[rs1] - reg[rs2], "-(c)"),
    CROp(encode_cxor, 8, lambda rs1, rs2: reg[rs1] ^ reg[rs2], "^(c)"),
    CROp(encode_cor, 8, lambda rs1, rs2: reg[rs1] | reg[rs2], "|(c)"),
    CROp(encode_cand, 8, lambda rs1, rs2: reg[rs1] & reg[rs2], "&(c)"),
    CLoadOp(encode_clw, 0, 31, 4, 4, lambda val: val, "lw(c)"),
    CLoadOp(encode_lh, 0, 1, 2, -2, lambda val: (val & 0xFFFF) - 0x10000 if (val & 0x8000) != 0 else val & 0xFFFF, "lh(c)"),
    CLoadOp(encode_lhu, 0, 1, 2, 2, lambda val: val & 0xFFFF, "lhu(c)"),
    CLoadOp(encode_lbu, 0, 3, 1, 1, lambda val: val & 0xFF, "lbu(c)"),
    LoadOp(InstructionLW, -0x800, 0x7ff, 1, 4, lambda val: val, "lw"),
    LoadOp(InstructionLH, -0x800, 0x7ff, 1, -2, lambda val: (val & 0xFFFF) - 0x10000 if (val & 0x8000) != 0 else val & 0xFFFF, "lh"),
    LoadOp(InstructionLB, -0x800, 0x7ff, 1, -1, lambda val: (val & 0xFF) - 0x100 if (val & 0x80) != 0 else val & 0xFF, "lb"),
    LoadOp(InstructionLHU, -0x800, 0x7ff, 1, 2, lambda val: val & 0xFFFF, "lhu"),
    LoadOp(InstructionLBU, -0x800, 0x7ff, 1, 1, lambda val: val & 0xFF, "lbu"),
    CStoreOp(encode_csw, 0, 31, 4, 4, lambda rs1: reg[rs1] & 0xFFFFFFFF, "sw(c)"),
    StoreOp(InstructionSW, -0x800, 0x7ff, 1, 4, lambda rs1: reg[rs1] & 0xFFFFFFFF, "sw"),
    StoreOp(InstructionSH, -0x800, 0x7ff, 1, 2, lambda rs1: reg[rs1] & 0xFFFF, "sh"),
    StoreOp(InstructionSB, -0x800, 0x7ff, 1, 1, lambda rs1: reg[rs1] & 0xFF, "sb"),
]

@cocotb.test()
async def test_random(dut):
    dut._log.info("Start")
  
    clock = Clock(dut.clk, 15.624, units="ns")
    cocotb.start_soon(clock.start())

    # Reset
    await reset(dut)

    # Should start reading flash after 1 cycle
    await ClockCycles(dut.clk, 1)
    await start_read(dut, 0)

    seed = random.randint(0, 0xFFFFFFFF)
    #seed = 3287254906

    latch_ram = False
    if latch_ram:
        RAM_SIZE = 32
        RAM = []
        for i in range(0, RAM_SIZE, 4):
            val = random.randint(0, 0xFFFFFFFF)
            await set_reg(dut, x1, val)
            await send_instr(dut, InstructionSW(tp, x1, i-0x100).encode())
            RAM.append(val & 0xFF)
            RAM.append((val >> 8) & 0xFF)
            RAM.append((val >> 16) & 0xFF)
            RAM.append((val >> 24) & 0xFF)
    
    debug = False
    if debug and latch_ram: print("RAM: ", RAM)

    for test in range(8):
        random.seed(seed + test)
        dut._log.info("Running test with seed {}".format(seed + test))
        for i in range(1, 16):
            if i == 3: reg[i] = 0x1000400
            elif i == 4: reg[i] = 0x8000000
            else:
                reg[i] = random.randint(-0x80000000, 0x7FFFFFFF)
                if debug: print("Set reg {} to {}".format(i, reg[i]))
                await load_reg(dut, i, reg[i])

        if False:
            for i in range(16):
                reg_value = (await read_reg(dut, i)).signed_integer
                if debug: print("Reg {} is {}".format(i, reg_value))
                assert reg_value == reg[i]

        last_instr = ops[0]
        for i in range(1000):
            while True:
                try:
                    instr = random.choice(ops)
                    instr.randomize()
                    rd = instr.get_valid_rd()
                    rs1 = instr.get_valid_rs1()
                    arg2 = instr.get_valid_arg2()

                    if instr.is_mem_op:
                        if latch_ram and random.randint(0, 2) == 2:
                            # Use latch RAM
                            addr = random.randint(0x7ffff00-instr.imm, 0x7ffff3c-instr.imm)
                            if instr.name[0] == 'l':
                                val = 0
                                for i in range(abs(instr.bytes)-1, -1, -1):
                                    val <<= 8
                                    val |= RAM[(addr + instr.imm + 0x1000 + i) % RAM_SIZE] 
                                instr.val = val
                                if debug: print(f"val {val} addr {addr + instr.imm:x}")
                        else:
                            # Use PSRAM
                            addr = random.randint(0x1000000-instr.imm, 0x1fffffc-instr.imm)
                            if debug: print(f"addr {addr + instr.imm:x}")
                        await set_reg(dut, instr.base_reg, addr)

                    instr.execute_fn(rd, rs1, arg2)
                    break
                except ValueError:
                    pass

            if debug: print("x{} = x{} {} {}, now {} {:08x}".format(rd, rs1, arg2, instr.name, reg[rd], instr.encode(rd, rs1, arg2)))
            await send_instr(dut, instr.encode(rd, rs1, arg2))
            if instr.is_mem_op:
                if addr < 0x4000000:
                    assert addr + instr.imm >= 0
                    assert addr + instr.imm < 0x2000000
                    await instr.do_mem_op(dut, addr + instr.imm)
                elif instr.name[0] == 's':
                    val = instr.fn(instr.rs1)
                    for i in range(instr.bytes):
                        RAM[(addr + instr.imm + 0x1000 + i) % RAM_SIZE] = val & 0xFF
                        val >>= 8
            #if True:
            #    assert await read_reg(dut, rd) == reg[rd] & 0xFFFFFFFF

        for i in range(16):
            reg_value = (await read_reg(dut, i))
            if debug: print("Reg x{} = {} should be {}".format(i, reg_value, reg[i]))
            assert reg_value & 0xFFFFFFFF == reg[i] & 0xFFFFFFFF
