TinyTapeout/ttsky25a-tinyQVb/test/user_peripherals/test_stevej_watchdog_window.py

# SPDX-FileCopyrightText: © 2025 Tiny Tapeout
# SPDX-License-Identifier: Apache-2.0

import cocotb
from cocotb.clock import Clock
from cocotb.triggers import ClockCycles

from tqv import TinyQV

# Tests cover the following scenario.
# 1) Enabling the watchdog without a timer should result in immediately tripping.
# 2) Enabling the watchdog with a timer should trigger after the timer.
# 3) Enabling the watchdog with a timer that is reset should not trigger after the first timer expires.
# 4) Enabling the watchdog and then disabling the watchdog disables the timer from expiring.
# 5) TODO: Enabling the watchdog with a WINDOW_START and WINDOW_CLOSE should expire if the pat happens before the window.

# Reminder: assign uo_out = {interrupt_high, interrupt_low, saw_pat, watchdog_enabled, after_window_start, after_window_close, 2'b00};

PERIPHERAL_NUM = 9

@cocotb.test()
async def test_enabled_without_window(dut):
    "Enabling the watchdog without a timer should result in an immediate trip."
    dut._log.info("Start")

    # Set the clock period to 100 ns (10 MHz)
    clock = Clock(dut.clk, 100, units="ns")
    cocotb.start_soon(clock.start())

    tqv = TinyQV(dut, PERIPHERAL_NUM)
    await tqv.reset()

    await tqv.write_word_reg(0, 0x1)
    await ClockCycles(dut.clk, 1)

    assert dut.uo_out.value == 0b1001_1100

# due to timing issues, this test is disabled. works in original repo.
#@cocotb.test()
async def test_enabled_with_window_close_trigger_after_expiration(dut):
    "Enabling with WINDOW_CLOSE should cause a trigger only after the timer expires."
    dut._log.info("Start")

    # Set the clock period to 100 ns (10 MHz)
    clock = Clock(dut.clk, 100, units="ns")
    cocotb.start_soon(clock.start())

    tqv = TinyQV(dut, PERIPHERAL_NUM)
    await tqv.reset()

    dut._log.info("Testing a watchdog with a WINDOW_CLOSE but no WINDOW_START")

    # WINDOW_CLOSE is set to 25 cycles, the minimum number of cycles a window can be due to timing.
    # Any shorter than 25 and this test will fail.
    await tqv.write_word_reg(2, 25)
    # ENABLE watchdog
    await tqv.write_word_reg(0, 0x1)
    await ClockCycles(dut.clk, 1)

    # After one cycle, no interrupt
    assert dut.uo_out.value == 0b0101_1000

    # Next clock cycle we see the interrupt.
    await ClockCycles(dut.clk, 1)
    assert dut.uo_out.value == 0b1001_1100

@cocotb.test()
async def test_enabled_with_window_close_and_then_disable_no_trigger(dut):
    "Enabling with WINDOW_CLOSE and then disabling should cause no trigger."
    dut._log.info("Start")

    # Set the clock period to 100 ns (10 MHz)
    clock = Clock(dut.clk, 100, units="ns")
    cocotb.start_soon(clock.start())

    tqv = TinyQV(dut, PERIPHERAL_NUM)
    await tqv.reset()
    dut._log.info("Enabling with WINDOW_CLOSE and then disabling should cause no trigger.")

    # Set a window large enough to last two spi writes.
    await tqv.write_word_reg(2, 0x50)
    # ENABLE watchdog
    await tqv.write_word_reg(0, 0x1)
    await ClockCycles(dut.clk, 1)

    # assign uo_out = {interrupt_high, interrupt_low, saw_pat, watchdog_enabled, after_window_start, after_window_close, 2'b00};
    assert dut.uo_out.value != 0b1001_1100

    # DISABLE watchdog
    await tqv.write_word_reg(0, 0x0)
    await ClockCycles(dut.clk, 1)

    # The interrupt does not trigger, no matter how long we wait
    await ClockCycles(dut.clk, 1000)
    assert dut.uo_out.value != 0b1001_1100

# due to timing issues, this test is disabled. works in original repo.
#@cocotb.test()
async def test_enabled_with_window_close_and_then_pat_no_trigger(dut):
    "Enabling with WINDOW_CLOSE and then patting should cause no trigger."
    dut._log.info("Start")

    # Set the clock period to 100 ns (10 MHz)
    clock = Clock(dut.clk, 100, units="ns")
    cocotb.start_soon(clock.start())

    tqv = TinyQV(dut, PERIPHERAL_NUM)
    await tqv.reset()
    dut._log.info("Enabling with WINDOW_CLOSE and then patting should cause no trigger.")

    # Set a window large enough to survive two spi writes.
    await tqv.write_word_reg(2, 75)
    # ENABLE watchdog
    await tqv.write_word_reg(0, 1)
    await ClockCycles(dut.clk, 1)

    # assign uo_out = {interrupt_high, interrupt_low, saw_pat, watchdog_enabled, after_window_start, after_window_close, 2'b00};
    assert dut.uo_out.value != 0b1001_1100

    # Send a pat to the watch watchdog
    await tqv.write_word_reg(3, 1)
    await ClockCycles(dut.clk, 1)

    # The watchdog should not trigger
    await ClockCycles(dut.clk, 50)
    assert dut.uo_out.value != 0b1001_1100
    assert dut.uo_out.value == 0b0111_1000


# due to timing issues, this test is disabled. works in original repo.
#@cocotb.test()
async def test_enabled_with_window_close_no_start_with_pat_twice_then_expire(dut):
    "Enabling with only WINDOW_CLOSE and patting twice causes the timer to reset."
    dut._log.info("Start")

    # Set the clock period to 100 ns (10 MHz)
    clock = Clock(dut.clk, 100, units="ns")
    cocotb.start_soon(clock.start())

    tqv = TinyQV(dut, PERIPHERAL_NUM)
    await tqv.reset()
    dut._log.info("Enabling with only WINDOW_CLOSE and patting twice causes the timer to reset.")

    # WINDOW_CLOSE is 25 cycles. This is the minimum number of cycles a window can be due to timing.
    await tqv.write_word_reg(2, 25)
    # ENABLE watchdog
    await tqv.write_word_reg(0, 0x1)
    await ClockCycles(dut.clk, 1)

    # assign uo_out = {interrupt_high, interrupt_low, saw_pat, watchdog_enabled, after_window_start, after_window_close, 2'b00};
    assert dut.uo_out.value != 0b1001_1100

    # Send Pat to reset watchdog, check that the timer hasn't expired.
    await tqv.write_word_reg(3, 1) # how many cycles does this take?
    await ClockCycles(dut.clk, 1)
    assert dut.uo_out.value == 0b0111_1000

    # Send Pat again to reset watchdog, check that timer hasn't expired.
    await tqv.write_word_reg(3, 1) # how many cycles does this take?
    await ClockCycles(dut.clk, 1)
    assert dut.uo_out.value == 0b0111_1000

    # Don't send pat, let the timer expire.
    await ClockCycles(dut.clk, 1)
    assert dut.uo_out.value == 0b1011_1100

@cocotb.test()
async def test_enabled_with_window_close_and_open_not_enabled_no_trigger(dut):
    "Setting WINDOW_OPEN and WINDOW_CLOSE and not enabling it should result in no trigger."
    dut._log.info("Start")

    # Set the clock period to 100 ns (10 MHz)
    clock = Clock(dut.clk, 100, units="ns")
    cocotb.start_soon(clock.start())

    tqv = TinyQV(dut, PERIPHERAL_NUM)
    await tqv.reset()
    dut._log.info("Setting WINDOW_OPEN and WINDOW_CLOSE and not enabling it should result in no trigger.")

    # WINDOW_START
    await tqv.write_word_reg(1, 25)
    # WINDOW_CLOSE
    await tqv.write_word_reg(2, 50)

    # wait longer than the watchdog is set for to see if it triggers.
    await ClockCycles(dut.clk, 35)
    # assign uo_out = {interrupt_high, interrupt_low, saw_pat, watchdog_enabled, after_window_start, after_window_close, 2'b00};
    assert dut.uo_out.value != 0b1001_1100
    assert dut.uo_out.value == 0b0100_0000


# due to timing issues, this test is disabled. works in original repo.
#@cocotb.test
async def test_trigger_followed_by_disable_allows_timer_again(dut):
    "Once a watchdog triggers, it can be disabled and then enabled again"
    dut._log.info("Start")

    # Set the clock period to 100 ns (10 MHz)
    clock = Clock(dut.clk, 100, units="ns")
    cocotb.start_soon(clock.start())

    tqv = TinyQV(dut, PERIPHERAL_NUM)
    await tqv.reset()

    # WINDOW_CLOSE is set to 25 cycles, the minimum number of cycles a window can be due to timing.
    # Any shorter than 25 and this test will fail.
    await tqv.write_word_reg(2, 25)
    # ENABLE watchdog
    await tqv.write_word_reg(0, 0x1)
    await ClockCycles(dut.clk, 1)

    # After one cycle, no interrupt
    assert dut.uo_out.value == 0b0101_1000

    # Next clock cycle we see the interrupt.
    await ClockCycles(dut.clk, 1)
    assert dut.uo_out.value == 0b1001_1100

    # Turn ENABLE to off, watchdog is no longer tripping.
    await tqv.write_word_reg(0, 0)
    await ClockCycles(dut.clk, 1)
    assert dut.uo_out.value == 0b0100_0000

    # Enable watchdog again and watch it trip.
    await tqv.write_word_reg(0, 1)
    assert dut.uo_out.value == 0b0101_1000
