TinyTapeout/ttsky25a-tinyQVb/test/user_peripherals/byte_example.py

# SPDX-FileCopyrightText: © 2024 Tiny Tapeout
# SPDX-License-Identifier: Apache-2.0

import cocotb
from cocotb.clock import Clock
from cocotb.triggers import ClockCycles

from tqv import TinyQV

PERIPHERAL_NUM = 31

@cocotb.test()
async def test_project(dut):
    dut._log.info("Start")

    # Set the clock period to 100 ns (10 MHz)
    clock = Clock(dut.clk, 100, units="ns")
    cocotb.start_soon(clock.start())

    tqv = TinyQV(dut, PERIPHERAL_NUM)

    # Reset
    await tqv.reset()

    dut._log.info("Test project behavior")

    # Test register write and read back
    await tqv.write_reg(0, 20)
    assert await tqv.read_reg(0) == 20

    # Set an input value, in the example this will be added to the register value
    dut.ui_in.value = 30

    # Wait for two clock cycles to see the output values, because ui_in is synchronized over two clocks,
    # and a further clock is required for the output to propagate.
    await ClockCycles(dut.clk, 3)

    # The following assersion is just an example of how to check the output values.
    # Change it to match the actual expected output of your module:
    assert dut.uo_out.value == 50

    # Input value should be read back from register 1
    assert await tqv.read_reg(1) == 30

    # Zero should be read back from register 2
    assert await tqv.read_reg(2) == 0

    # A second write should work
    await tqv.write_reg(0, 40)
    assert dut.uo_out.value == 70
