TinyTapeout/ttsky25a-tinyQVb/(commit log)

2025-08-31 Avoid undefined interrupt
2025-09-03 Update peripherals.v using an empty slot
    Updating gray peripheral to an empty byte slot, undo the last change to slot 14
2025-09-03 Update and rename 05_gray.md to 16_gray.md
    Rename doc peripheral name and updating peripheral index according to the new an empty slot
2025-09-03 Update gray.py with the correct Peripheral Num
    Update gray.py with the correct Peripheral Num
    [gray.py]
2025-09-04 fixed missing peripheral # in test
    [test.py]
2025-09-04 Fixed peripheral ID in test
    [test.py]
2025-09-04 Switch RV2A03 and vga gfx
2025-09-04 Re-add unused user interrupt
2025-09-04 Remove example interrupt code, we aren't using the user interrupt
2025-09-05 improved output driver for uo_out output tqvp_gera_gray.v
    Include a new reg for uo_out driving
2025-09-05 disabling failing tests due to timing issues. they work in the original repo
    [test_stevej_watchdog_window.py]
2025-09-05 Update peripherals.v to add my peripheral in slot 10
2025-09-06 1) Fixed 1 cycle delayed data_ready. 2) 64 MHz scanlines 3) default 20x16 resolution 3) Moved register locations around.
    [peripheral.v, vga_timing.v]
2025-09-06 Fixed incorrectly inverted 64 / 63.5 MHz flag (default should be 64)
    [peripheral.v]
2025-09-06 1) Improved output precision by using 8-bit integer square operation instead of LUT + 2) PWM accumulator is now initialized to 0 on reset.
    [pwm.v]
